legokor/nyak-tanfolyam/eagle/stmboard.brd

## EAGLE design eagle/stmboard.brd (2019-04-23)

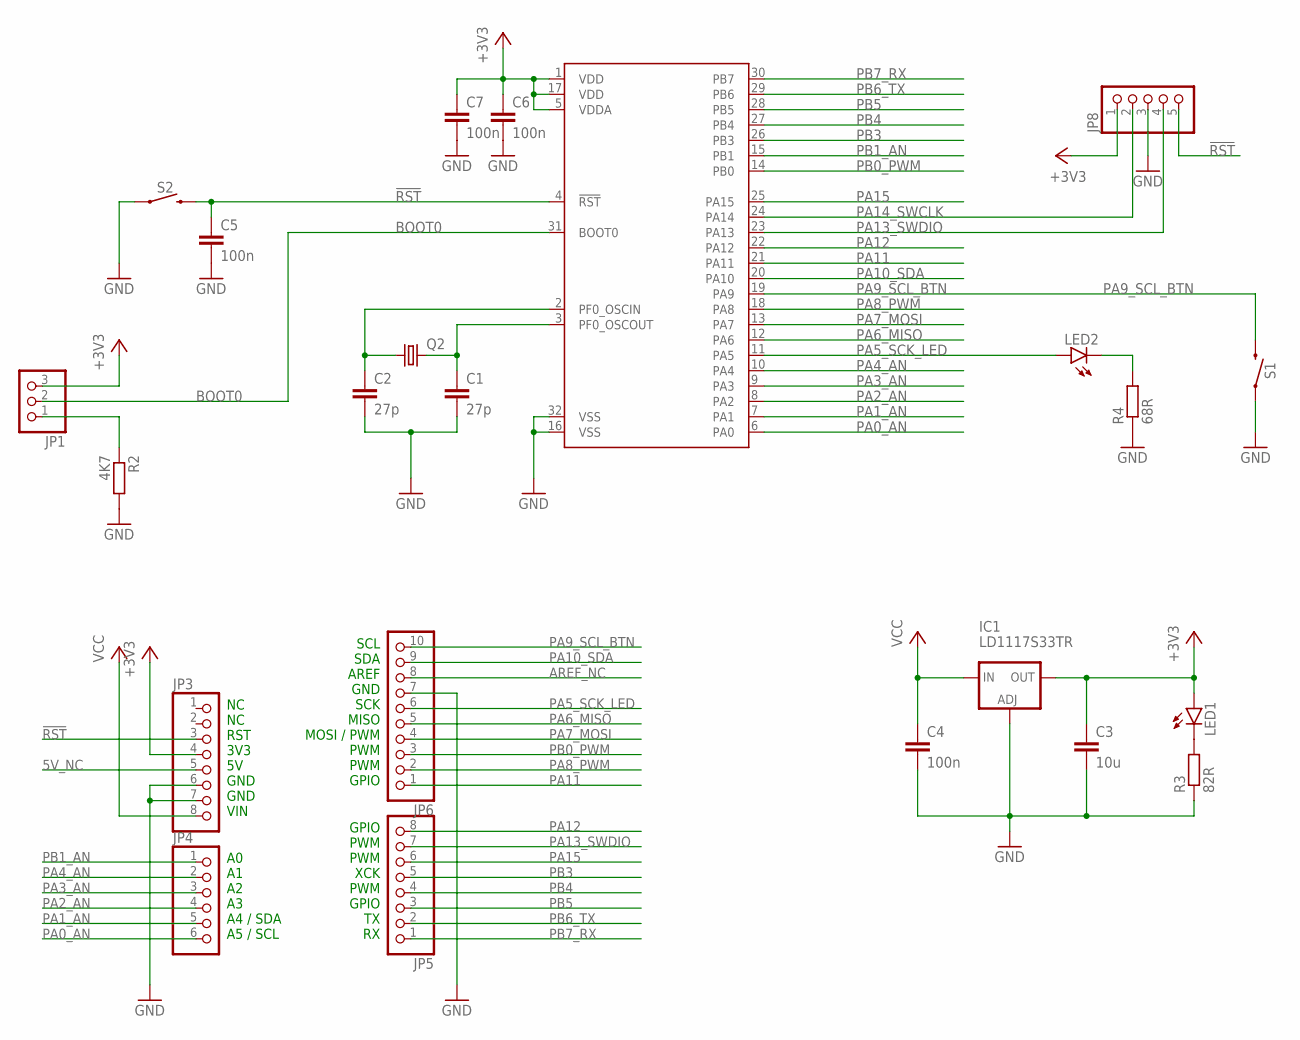
[picture p25: schematic stmboard.sch]

Parts:
C1, C2: 27p; C1206
C3: 10u; C1206K
C4, C5, C6, C7: 100n; C1206K
IC1: LD1117S33TR; SOT223
JP1: PINHD-1X3; 1X03
JP3, JP5: PINHD-1X8; 1X08
JP4: PINHD-1X6; 1X06
JP6: PINHD-1X10; 1X10
JP8: PINHD-1X5; 1X05
LED1, LED2: LEDSMT1206; 1206
Q2: CRYSTALSM49; SM49
R2: 4K7; M1206
R3: 82R; M1206
R4: 68R; M1206
S1, S2: MOMENTARY-SWITCH-SPST-SMD-6.0X3.5MM; TACTILE_SWITCH_SMD_6.0X3.5MM
U$1: STM32F030; TQFP32-08

Connections:
5V_NC: JP3.5
!RST: C5.1, JP3.3, JP8.5, S2.2, U$1.4 (!RST)
+3V3: C3.1, C6.1, C7.1, IC1.4 (OUT), JP1.3, JP3.4, JP8.1, LED1.A, U$1.1 (VDD), U$1.5 (VDDA), U$1.17 (VDD)
AREF_NC: JP6.8
BOOT0: JP1.2, U$1.31 (BOOT0)
GND: C1.2, C2.2, C3.2, C4.2, C5.2, C6.2, C7.2, IC1.1 (ADJ), JP3.6, JP3.7, JP6.7, JP8.3, R2.2, R3.1, R4.1, S1.1, S2.1, U$1.16 (VSS), U$1.32 (VSS)
unnamed: LED1.C, R3.2
unnamed: LED2.C, R4.2
unnamed: JP1.1, R2.1
OSCI: C2.1, Q2.1, U$1.2 (PF0_OSCIN)
OSCO: C1.1, Q2.2, U$1.3 (PF0_OSCOUT)
PA0_AN: JP4.6, U$1.6 (PA0)
PA1_AN: JP4.5, U$1.7 (PA1)
PA2_AN: JP4.4, U$1.8 (PA2)
PA3_AN: JP4.3, U$1.9 (PA3)
PA4_AN: JP4.2, U$1.10 (PA4)
PA5_SCK_LED: JP6.6, LED2.A, U$1.11 (PA5)
PA6_MISO: JP6.5, U$1.12 (PA6)
PA7_MOSI: JP6.4, U$1.13 (PA7)
PA8_PWM: JP6.2, U$1.18 (PA8)
PA9_SCL_BTN: JP6.10, S1.2, U$1.19 (PA9)
PA10_SDA: JP6.9, U$1.20 (PA10)
PA11: JP6.1, U$1.21 (PA11)
PA12: JP5.8, U$1.22 (PA12)
PA13_SWDIO: JP5.7, JP8.4, U$1.23 (PA13)
PA14_SWCLK: JP8.2, U$1.24 (PA14)
PA15: JP5.6, U$1.25 (PA15)
PB0_PWM: JP6.3, U$1.14 (PB0)
PB1_AN: JP4.1, U$1.15 (PB1)
PB3: JP5.5, U$1.26 (PB3)
PB4: JP5.4, U$1.27 (PB4)
PB5: JP5.3, U$1.28 (PB5)
PB6_TX: JP5.2, U$1.29 (PB6)
PB7_RX: JP5.1, U$1.30 (PB7)
VCC: C4.1, IC1.3 (IN), JP3.8

Notes on the sheet:
NC NC RST 3V3 5V GND GND VIN
A0 A1 A2 A3 A4 / SDA A5 / SCL
SCL SDA AREF GND SCK MISO MOSI / PWM PWM PWM GPIO
GPIO PWM PWM XCK PWM GPIO TX RX

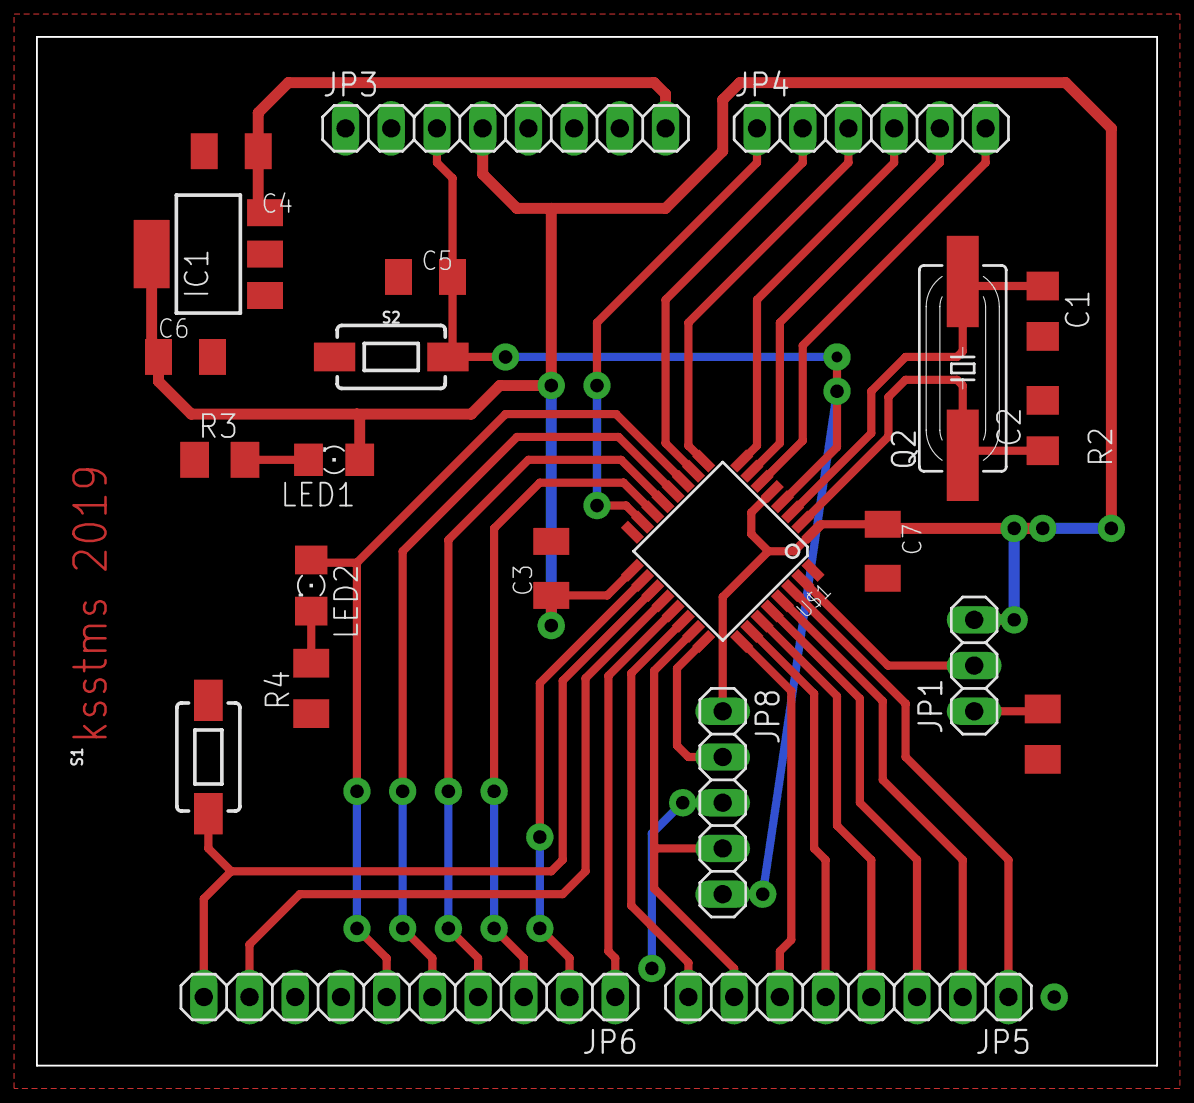
[picture p26: board stmboard.brd from above]

Board: 2 copper layers, 62.2 x 57.1 mm, 23 parts (0 on the bottom side), 33 nets.
