legokor/nyak-tanfolyam/sw/example_project/Inc/main.h

#define led_Pin GPIO_PIN_5
#define led_GPIO_Port GPIOA
#define button_Pin GPIO_PIN_9
#define button_GPIO_Port GPIOA
