legokor/nyak-tanfolyam/(commit log)

2019-04-22 initial version
    [stmboard.brd, stmboard.sch]
2019-04-22 updated eagle version
    [stmboard.brd]
2019-04-22 fixed arduino header spacing
    [stmboard.brd]
2019-04-22 changed boot0 jumper to 3-pin
    [stmboard.brd, stmboard.sch]
2019-04-22 made via diameters bigger
    [stmboard.brd]
2019-04-22 some wiring touch-ups
    [stmboard.brd]
2019-04-23 more wiring touch-ups
    [stmboard.brd]
2019-04-23 added part values
    [stmboard.brd, stmboard.sch]
2019-04-23 fixed SWDIO/SWCLK signal names
    [stmboard.brd, stmboard.sch]
2019-04-23 fixed value labels on brd
    [stmboard.brd, stmboard.sch]
